Brain-dll/MIDDLE-ALTITUDE-AVIONIC-SYSTEM/PIC/ground.JPG

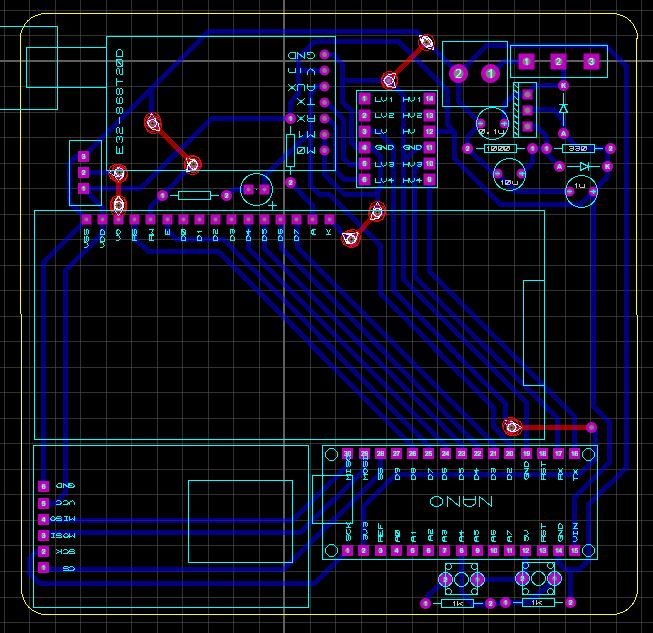
PIC/ground.JPG
