Brain-dll/MIDDLE-ALTITUDE-AVIONIC-SYSTEM/PIC/telemetry.JPG

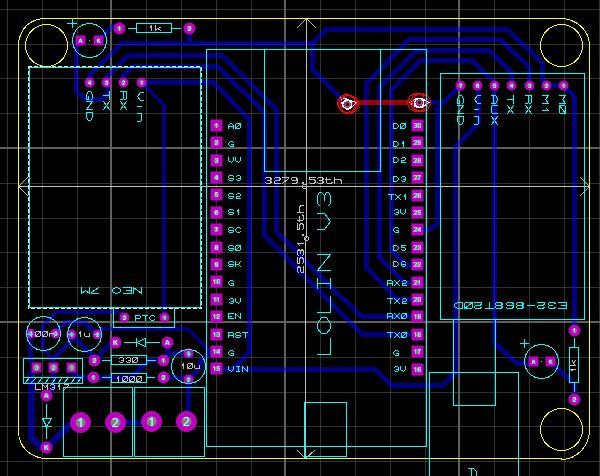
PIC/telemetry.JPG
