Brain-dll/MIDDLE-ALTITUDE-AVIONIC-SYSTEM/PIC/ignition.JPG

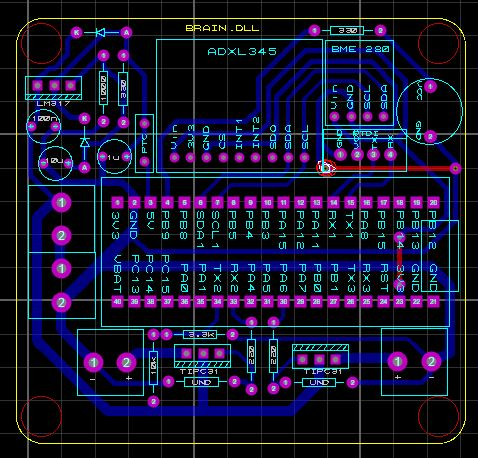
PIC/ignition.JPG
