Brain-dll/MIDDLE-ALTITUDE-AVIONIC-SYSTEM/DOC/GROUND_PCB.pdf

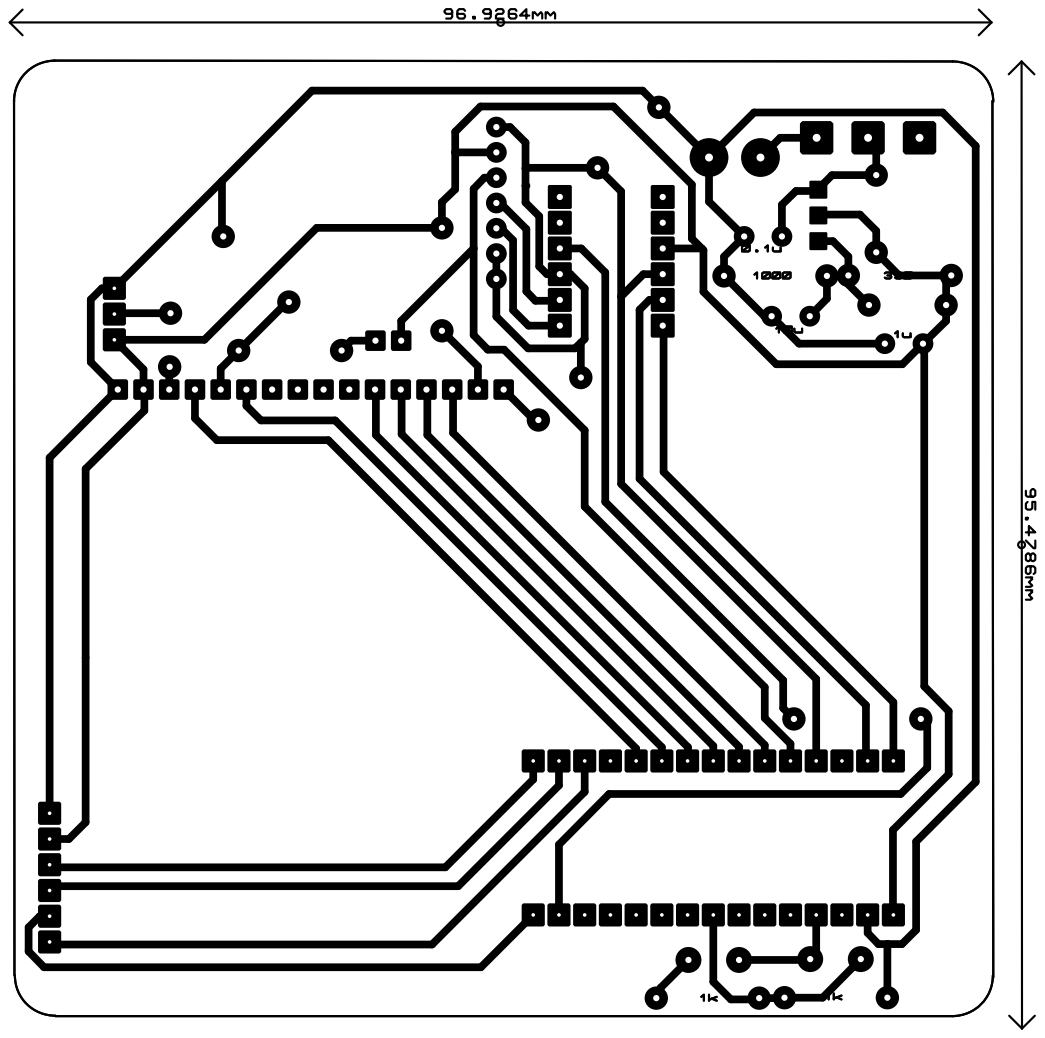
[picture p47: page 1]
