Brain-dll/MIDDLE-ALTITUDE-AVIONIC-SYSTEM/DOC/GROUND_STATION.pdf

U2

U5

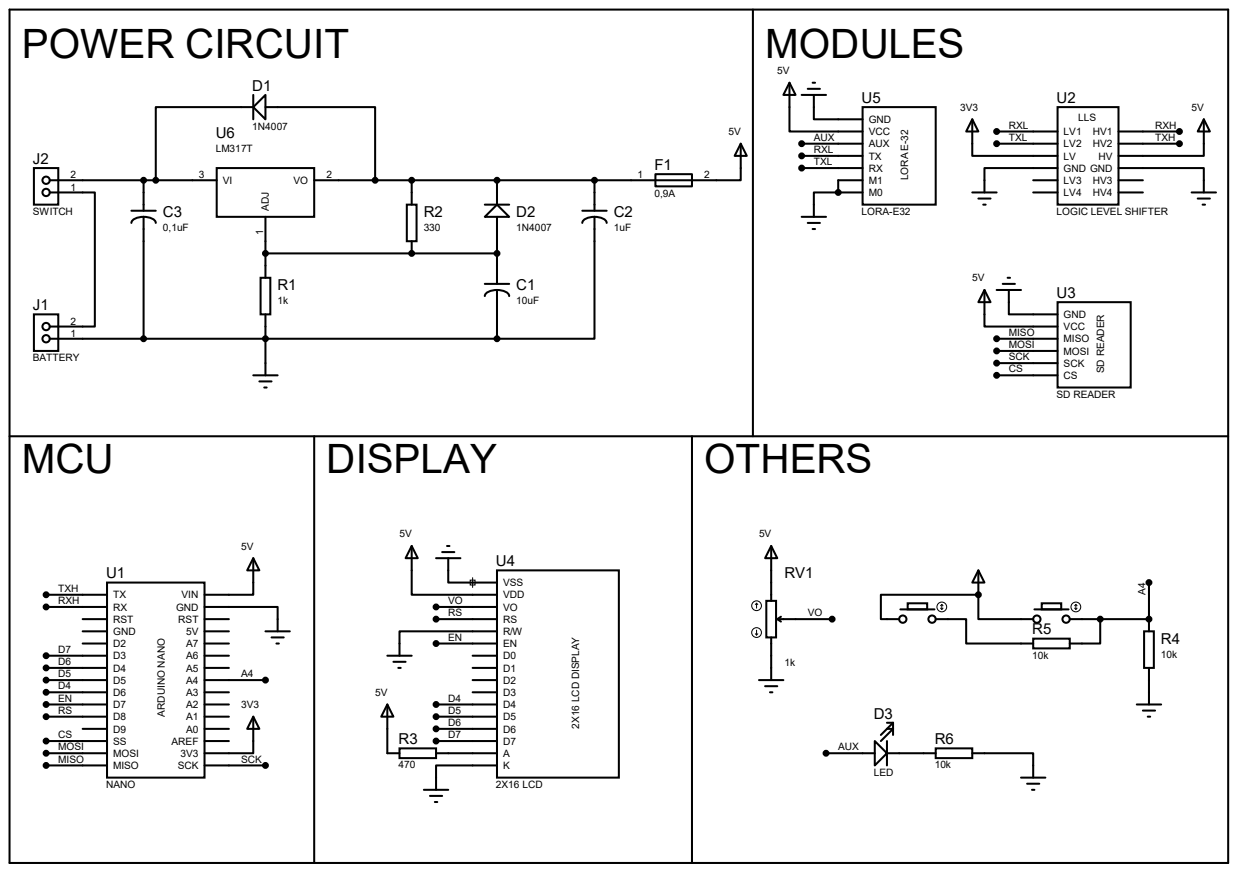
[picture p48: page 1]
