Brain-dll/MIDDLE-ALTITUDE-AVIONIC-SYSTEM/DOC/IGNITION.pdf

U2

D1

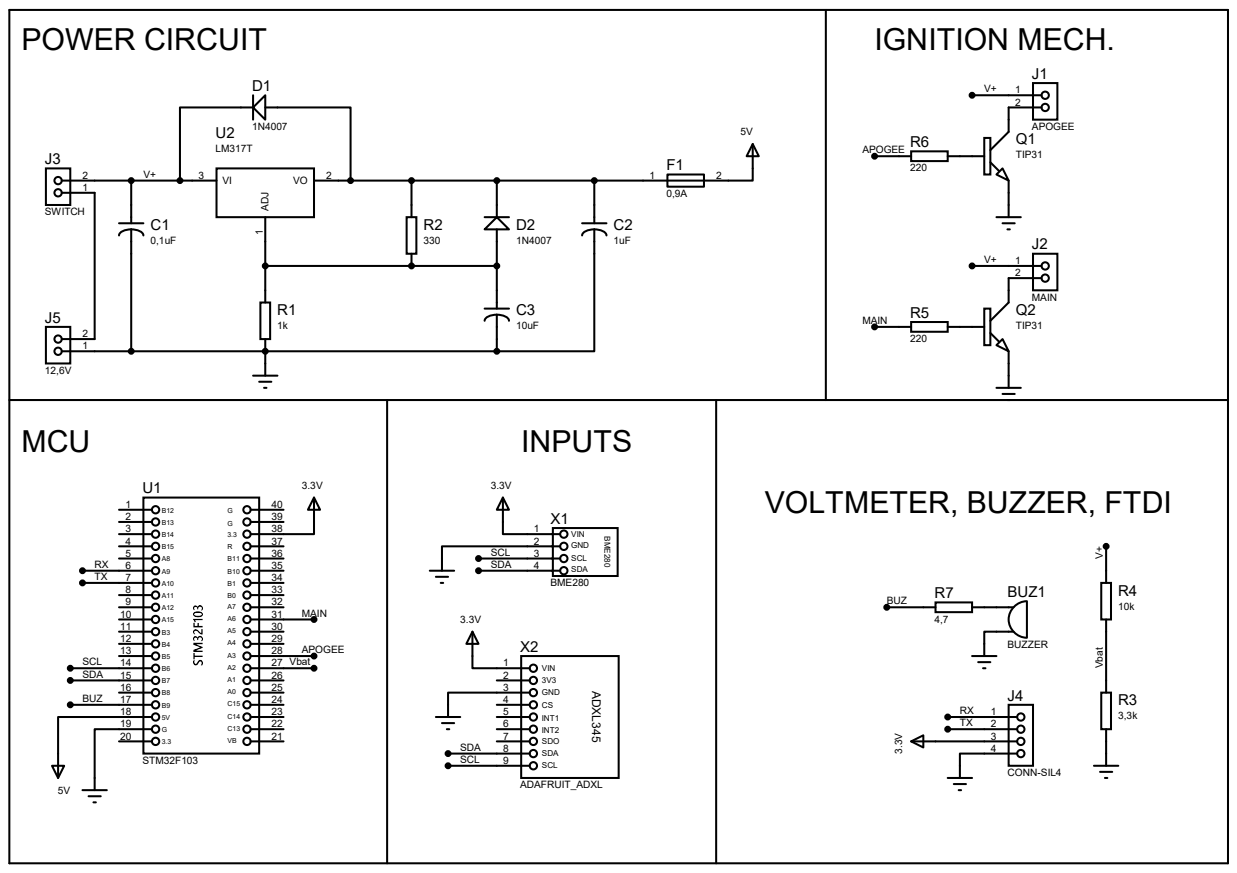
[picture p49: page 1]
