Brain-dll/MIDDLE-ALTITUDE-AVIONIC-SYSTEM/(list of files, drawings)

Other design files:
HARDWARE/GROUND.pdsprj
HARDWARE/IGNITION_son.pdsprj
HARDWARE/TELEMETRY.pdsprj
